BigSmartt01/Fall_Sensor/docs/images/dashboard_normal.png

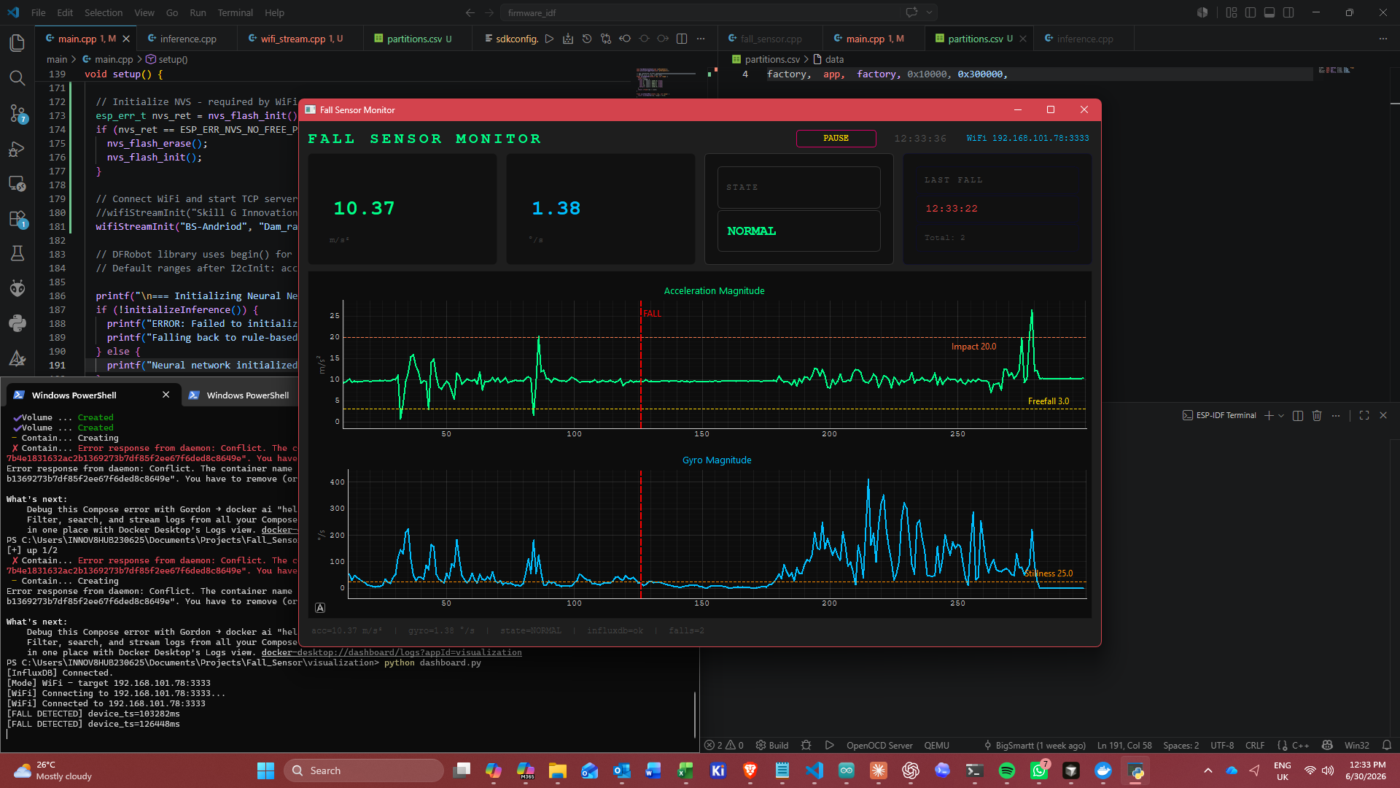
docs/images/dashboard_normal.png
