BigSmartt01/Fall_Sensor/docs/images/perfboard_bottom.jpg

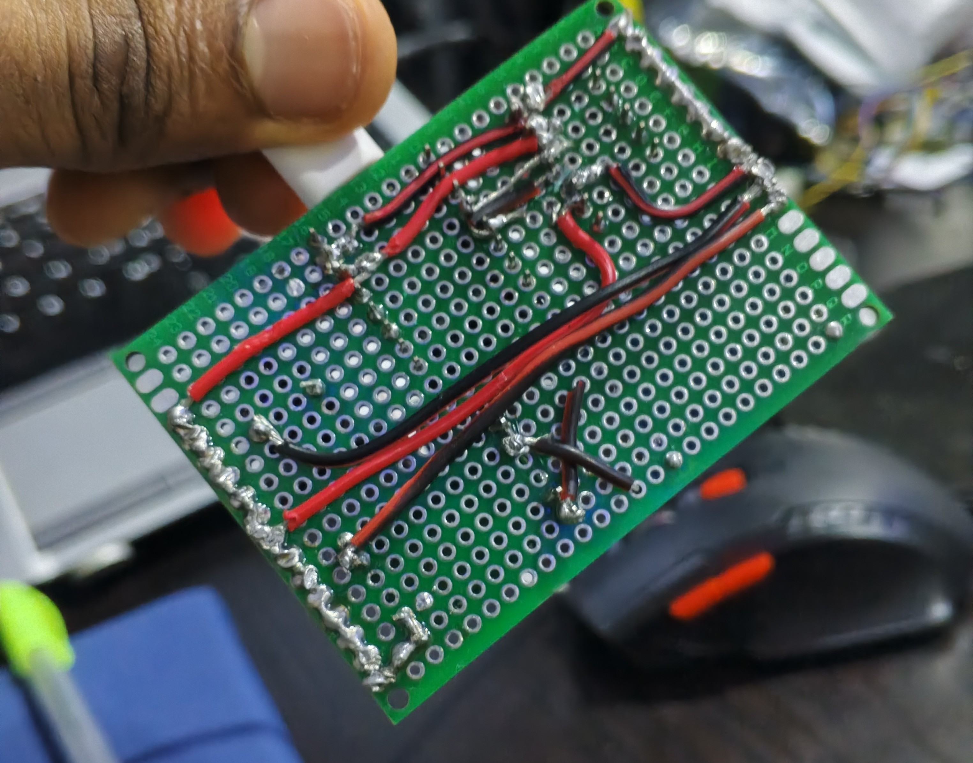
docs/images/perfboard_bottom.jpg
