BigSmartt01/Fall_Sensor/hardware/One-Layer/Alaafia_PCB_local.kicad_pcb

## KiCad design hardware/One-Layer/Alaafia_PCB_local.kicad_pcb (2026-07-03)

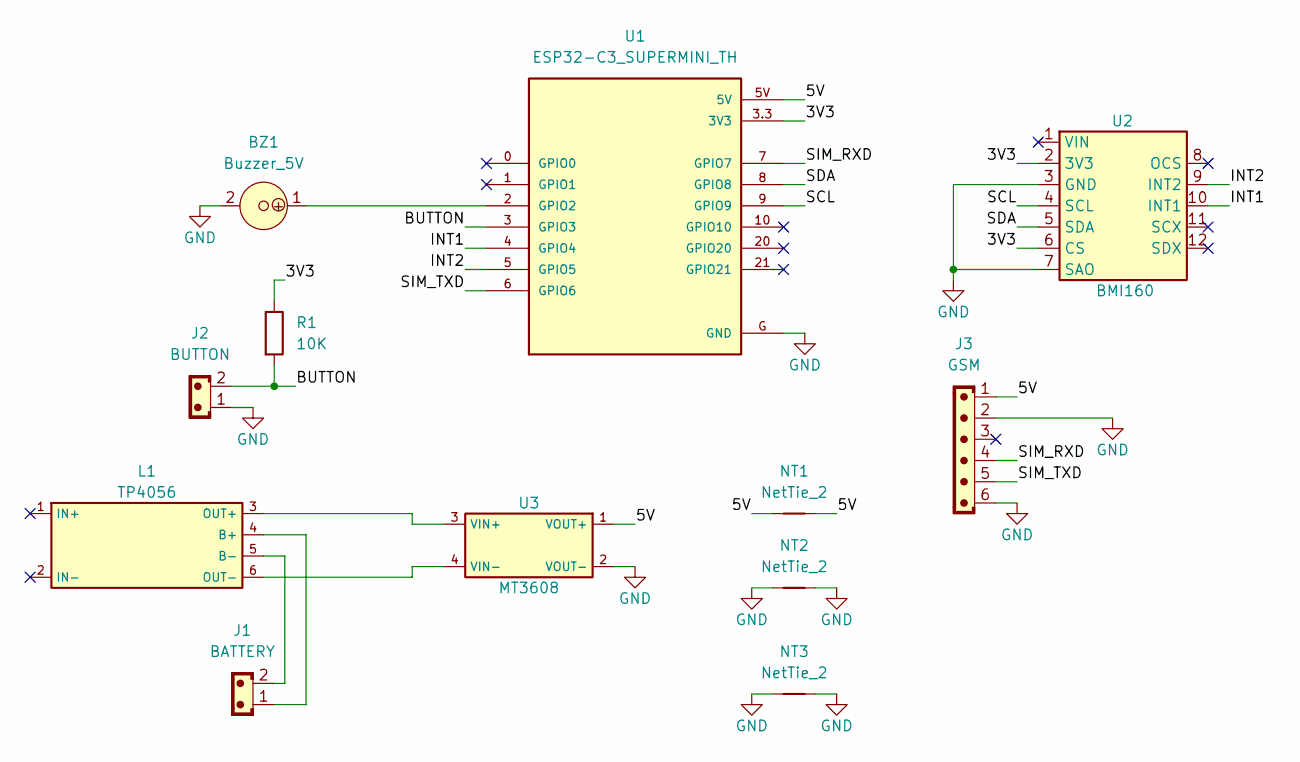
[picture p6: schematic Alaafia_PCB_local.kicad_sch, Alaafia_PCB]

Parts:
BZ1: Buzzer_5V; MagneticBuzzer_ProSignal_ABT-410-RC
J1: BATTERY; JST_EH_B2B-EH-A_1x02_P2.50mm_Vertical
J2: BUTTON; JST_EH_B2B-EH-A_1x02_P2.50mm_Vertical
J3: GSM; JST_EH_B6B-EH-A_1x06_P2.50mm_Vertical
L1: TP4056
NT1, NT3: NetTie_2; JUP_P5.08mm
NT2: NetTie_2; JUP_P14mm
R1: 10K; R_Axial_DIN0411_L9.9mm_D3.6mm_P15.24mm_Horizontal
U1: ESP32-C3_SUPERMINI_TH; MODULE_ESP32-C3_SUPERMINI_TH
U2: BMI160
U3: MT3608

Connections:
/3V3: R1.1, U1.3.3 (3V3), U2.2 (3V3), U2.6 (CS)
/5V: J3.1, NT1.1, NT1.2, U1.5V, U3.1 (VOUT+)
/BUTTON: J2.2, R1.2, U1.3 (GPIO3)
/INT1: U1.4 (GPIO4), U2.10 (INT1)
/INT2: U1.5 (GPIO5), U2.9 (INT2)
/SCL: U1.9 (GPIO9), U2.4 (SCL)
/SDA: U1.8 (GPIO8), U2.5 (SDA)
/SIM_RXD: J3.4, U1.7 (GPIO7)
/SIM_TXD: J3.5, U1.6 (GPIO6)
GND: BZ1.2, J2.1, J3.2, J3.6, NT2.1, NT2.2, NT3.1, NT3.2, U1.G (GND), U2.3 (GND), U2.7 (SAO), U3.2 (VOUT-)
unnamed: J1.1, L1.4 (B+)
unnamed: J1.2, L1.5 (B-)
unnamed: L1.3 (OUT+), U3.3 (VIN+)
unnamed: L1.6 (OUT-), U3.4 (VIN-)
unnamed: BZ1.1, U1.2 (GPIO2)

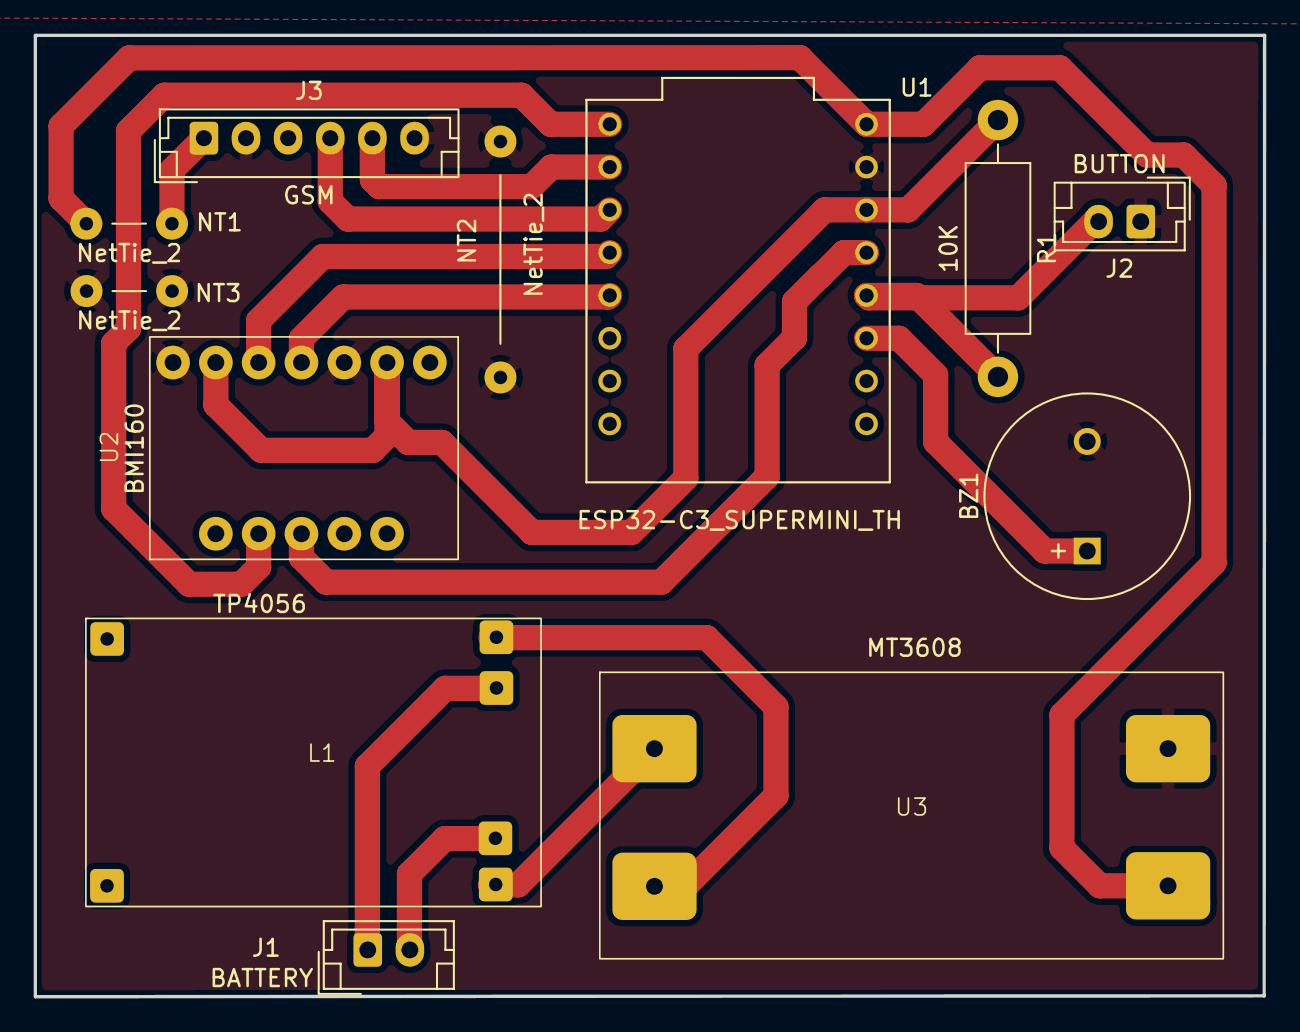
[picture p7: board Alaafia_PCB_local.kicad_pcb from above]

Board: 2 copper layers, 72.9 x 57.0 mm, 12 parts (0 on the bottom side), 15 nets.
