BigSmartt01/Fall_Sensor/firmware_idf/main/wifi_stream.h

#pragma once

#include <stdint.h>
#include <stdbool.h>

#ifdef __cplusplus
extern "C" {
#endif

/**
 * Initialize WiFi using NVS-stored credentials (STA + TCP stream server).
 * If credentials are missing or STA connect fails, starts softAP
 * "FallSensor_AP" with a captive portal (DNS catch-all + OS probe endpoints)
 * so the credential form opens automatically on phones/PCs.
 * Captive portal path blocks until credentials are saved and the device reboots.
 * Call once from setup() after BMI160 init.
 *
 * @param ssid     Unused (legacy); credentials come from NVS or softAP form
 * @param password Unused (legacy); credentials come from NVS or softAP form
 * @param port     TCP port for dashboard streaming after STA connect (e.g. 3333)
 */
void wifiStreamInit(const char* ssid, const char* password, uint16_t port);

/**
 * Send a null-terminated string line to the connected TCP client.
 * Appends '\n' automatically if not already present.
 * Falls back silently if no client is connected - USB Serial continues
 * to receive all output regardless.
 *
 * @param line   Null-terminated string to send
 */
void wifiStreamSend(const char* line);

/**
 * Send a formatted line to the connected TCP client.
 * Wrapper around wifiStreamSend with printf-style formatting.
 * Safe to call from any FreeRTOS task.
 *
 * @param fmt   printf-style format string
 * @param ...   variadic arguments
 */
void wifiStreamPrintf(const char* fmt, ...);

/**
 * Returns true if a TCP client is currently connected.
 */
bool wifiStreamConnected(void);

/**
 * Returns the ESP32-C3 IP address as a string.
 * Valid after wifiStreamInit() completes successfully.
 * Returns "0.0.0.0" if not connected.
 */
const char* wifiStreamIP(void);

#ifdef __cplusplus
}
#endif
