BigSmartt01/Fall_Sensor/(commit log)

2026-06-08 One layer designed
    [Alaafia_PCB_local.kicad_pcb, Alaafia_PCB_local.kicad_sch]
2026-06-17 Initial commit with all files
    [partitions.csv]
2026-06-18 Remove esp-tflite-micro from index to re-add as submodule
    [partitions.csv]
2026-06-18 I2C error off, but not responidng yet
    [main.cpp]
2026-06-19 Before pulling idf framework
    [Alaafia_PCB_local.kicad_pcb]
2026-06-19 IDF and I2C responds with printf rather than Serial.print or Serial.printf
2026-06-30 Integrated WiFi streaming and dashboard for both serial and wifi
    [partitions.csv]
2026-07-01 Started two layer board
    [Alaafia_PCB_local.kicad_pcb, Alaafia_PCB_local.kicad_sch, Fall_Sensor.kicad_pcb, Fall_Sensor.kicad_sch]
2026-07-03 Local PCB with button and SIM JST
    [Alaafia_PCB_local.kicad_pcb, Alaafia_PCB_local.kicad_sch]
2026-07-08 Add captive portal for FallSensor_AP WiFi provisioning
    DNS catch-all and OS probe endpoints open the credential form automatically
    without typing 192.168.4.1. Also tighten STA retry to 5 x 10s before AP.
    [wifi_stream.cpp, wifi_stream.h]
2026-07-08 Track submodule remote branches and document keep-current policy
    Pin both submodules to master in .gitmodules and add AGENTS.md so agents
    always update, commit, and do not leave dirty submodule pointers.
